Decending/E7020E_lab2/Lab1.kicad_pcb

## KiCad design Lab1.kicad_pcb (2021-02-03)

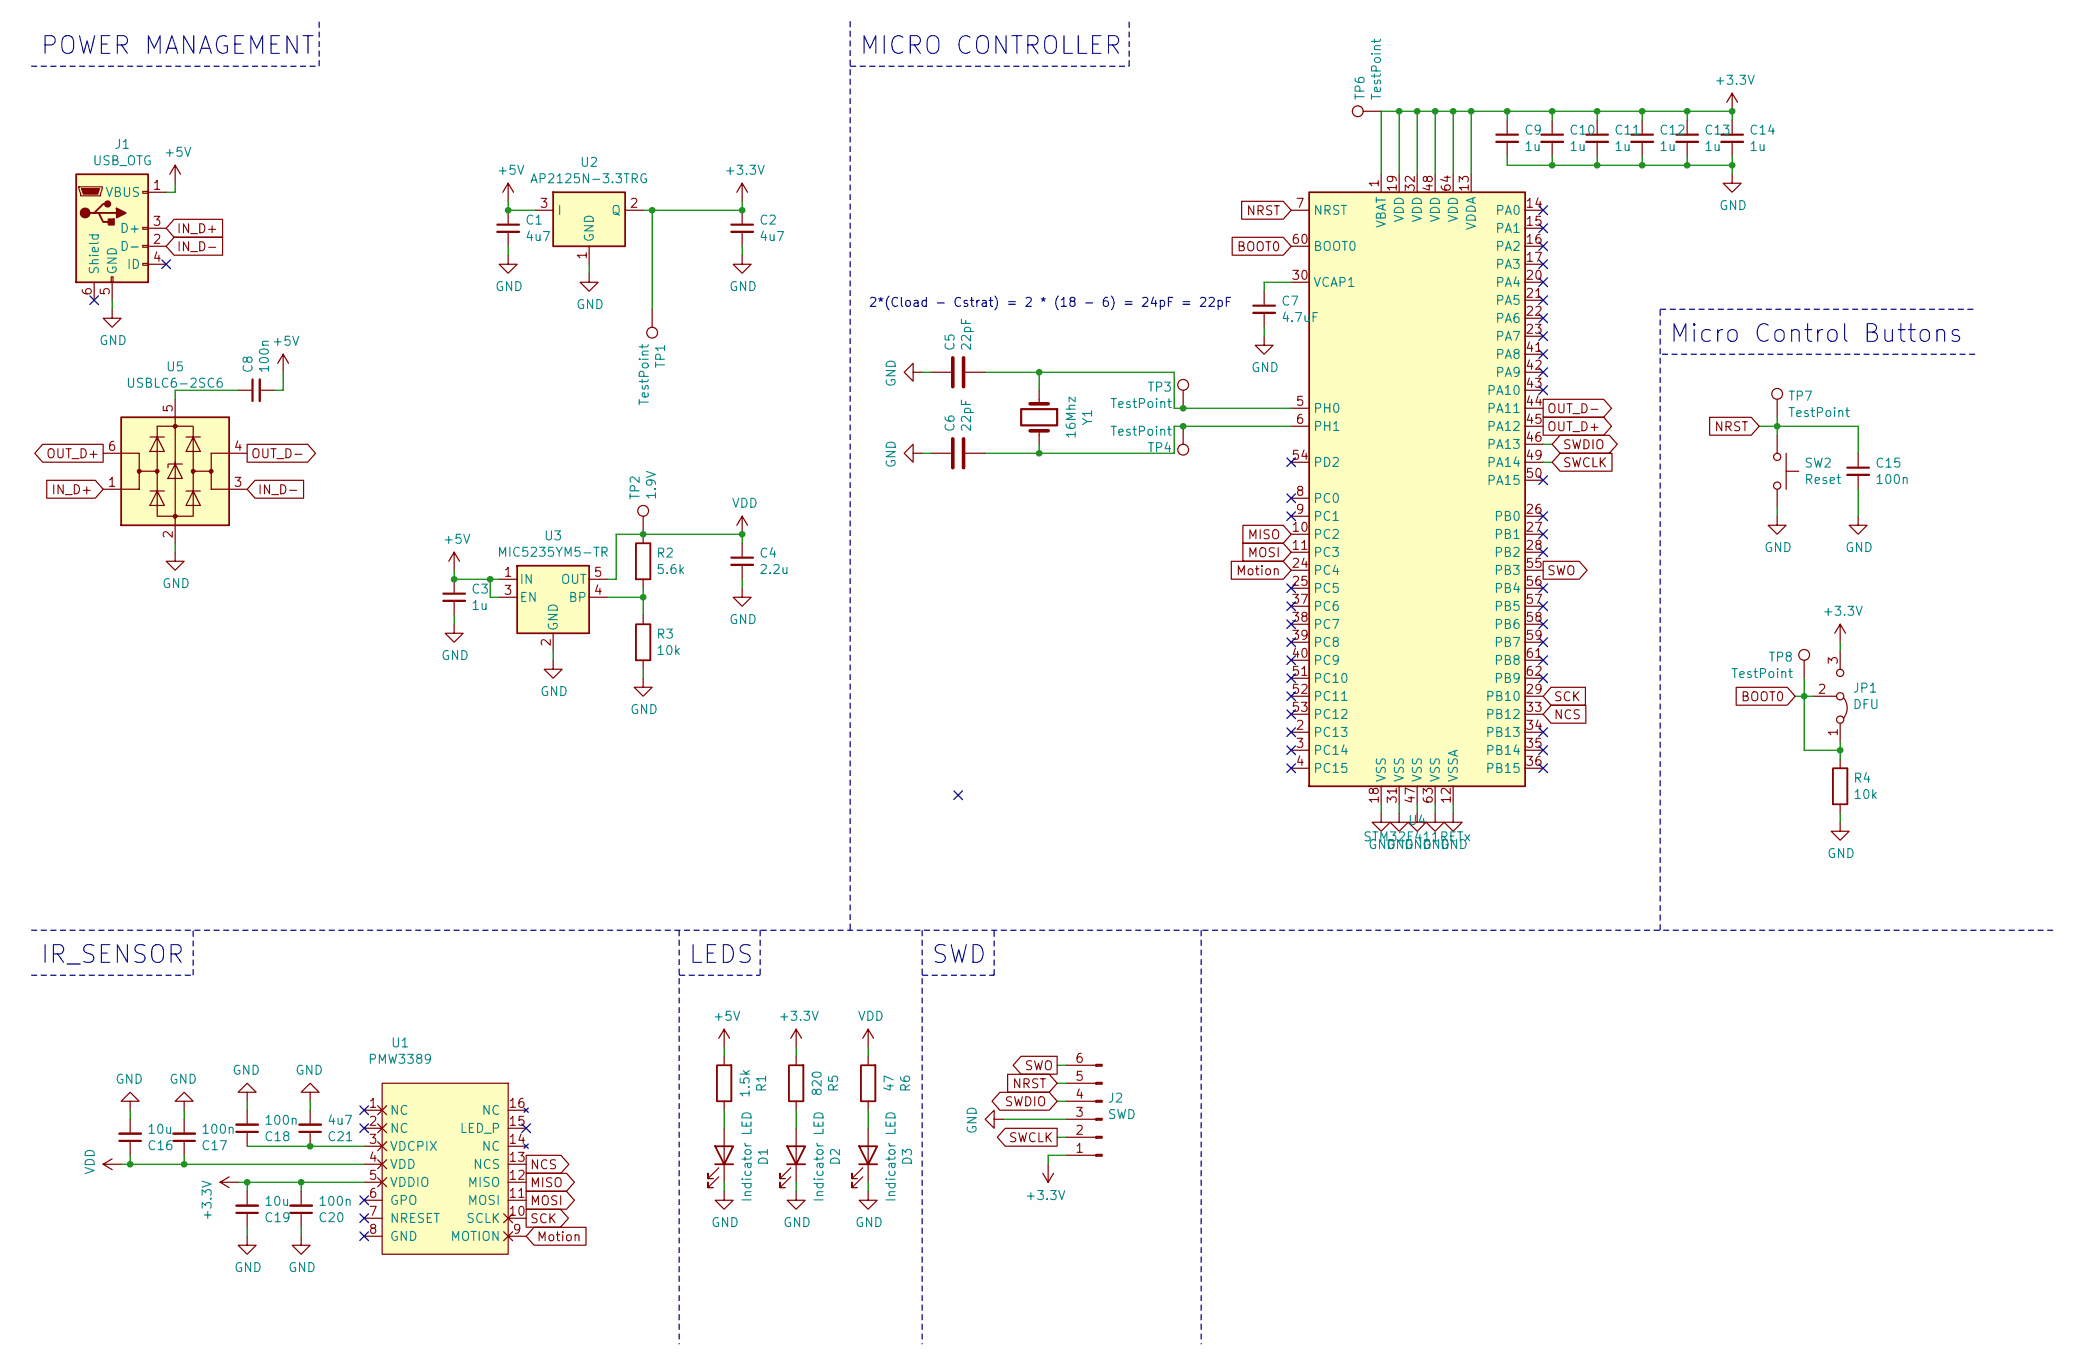
[picture p1: schematic Lab1.sch]

Parts:
C1, C2, C21: 4u7; C_0805_2012Metric_Pad1.18x1.45mm_HandSolder
C3, C9, C10, C11, C12, C13, C14: 1u; C_0805_2012Metric_Pad1.18x1.45mm_HandSolder
C4: 2.2u; C_0805_2012Metric_Pad1.18x1.45mm_HandSolder
C5, C6: 22pF; C_0805_2012Metric_Pad1.18x1.45mm_HandSolder
C7: 4.7uF; C_0805_2012Metric_Pad1.18x1.45mm_HandSolder
C8, C15, C17, C18, C20: 100n; C_0805_2012Metric_Pad1.18x1.45mm_HandSolder
C16, C19: 10u; C_0805_2012Metric_Pad1.18x1.45mm_HandSolder
D1, D2, D3: Indicator LED; LED_1206_3216Metric
J1: USB_OTG; USB_Mini-B_Tensility_54-00023_Vertical
J2: SWD; PinHeader_1x06_P2.00mm_Vertical
JP1: DFU; FanPinHeader_1x03_P2.54mm_Vertical
R1: 1.5k; R_0815_2038Metric_Pad1.20x4.05mm_HandSolder
R2: 5.6k; R_0815_2038Metric_Pad1.20x4.05mm_HandSolder
R3, R4: 10k; R_0815_2038Metric_Pad1.20x4.05mm_HandSolder
R5: 820; R_0815_2038Metric_Pad1.20x4.05mm_HandSolder
R6: 47; R_0815_2038Metric_Pad1.20x4.05mm_HandSolder
SW2: Reset; SW_SPST_B3U-1000P
TP1, TP3, TP4, TP6, TP7, TP8: TestPoint; TestPoint_Pad_1.5x1.5mm
TP2: 1.9V; TestPoint_Pad_1.5x1.5mm
U1: PMW3389
U2: AP2125N-3.3TRG; TO-252-3_TabPin2
U3: MIC5235YM5-TR; SOT-23-5
U4: STM32F411RETx; LQFP-64_10x10mm_P0.5mm
U5: USBLC6-2SC6; SOT-23-6
Y1: 16Mhz; Crystal_SMD_0603-2Pin_6.0x3.5mm_HandSoldering

Connections:
+3V3: C2.1, C9.1, C10.1, C11.1, C12.1, C13.1, C14.1, C19.2, C20.2, J2.1, JP1.3 (B), R5.2, TP1.1, TP6.1, U1.5 (VDDIO), U2.2 (Q), U4.1 (VBAT), U4.13 (VDDA), U4.19 (VDD), U4.32 (VDD), U4.48 (VDD), U4.64 (VDD)
+5V: C1.1, C3.1, C8.2, J1.1 (VBUS), R1.2, U2.3 (I), U3.1 (IN), U3.3 (EN)
BOOT0: JP1.1 (A), JP1.2 (C), R4.1, TP8.1, U4.60 (BOOT0)
GND: C1.2, C2.2, C3.2, C4.2, C5.1, C6.1, C7.2, C9.2, C10.2, C11.2, C12.2, C13.2, C14.2, C15.2, C16.2, C17.2, C18.2, C19.1, C20.1, C21.2, D1.1 (K), D2.1 (K), D3.1 (K), J1.5 (GND), J2.3, R3.2, R4.2, SW2.2, U2.1 (GND), U3.2 (GND), U4.12 (VSSA), U4.18 (VSS), U4.31 (VSS), U4.47 (VSS), U4.63 (VSS), U5.2 (GND)
IN_D+: J1.3 (D+), U5.1 (I/O1)
IN_D-: J1.2 (D-), U5.3 (I/O2)
MISO: U1.12 (MISO), U4.10 (PC2)
MOSI: U1.11 (MOSI), U4.11 (PC3)
Motion: U1.9 (MOTION), U4.24 (PC4)
NCS: U1.13 (NCS), U4.33 (PB12)
NRST: C15.1, J2.5, SW2.1, TP7.1, U4.7 (NRST)
unnamed: C5.2, TP3.1, U4.5 (PH0), Y1.1
unnamed: C6.2, TP4.1, U4.6 (PH1), Y1.2
unnamed: C7.1, U4.30 (VCAP1)
unnamed: C8.1, U5.5 (VBUS)
unnamed: C18.1, C21.1, U1.3 (VDCPIX)
unnamed: D1.2 (A), R1.1
unnamed: D2.2 (A), R5.1
unnamed: D3.2 (A), R6.1
unnamed: R2.2, R3.1, U3.4 (BP)
OUT_D+: U4.45 (PA12), U5.6 (I/O1)
OUT_D-: U4.44 (PA11), U5.4 (I/O2)
SCK: U1.10 (SCLK), U4.29 (PB10)
SWCLK: J2.2, U4.49 (PA14)
SWDIO: J2.4, U4.46 (PA13)
SWO: J2.6, U4.55 (PB3)
VDD: C4.1, C16.1, C17.1, R2.1, R6.2, TP2.1, U1.4 (VDD), U3.5 (OUT)

Notes on the sheet:
2*(Cload - Cstrat) = 2 * (18 - 6) = 24pF = 22pF
POWER MANAGEMENT
MICRO CONTROLLER
IR_SENSOR
LEDS
SWD
Micro Control Buttons

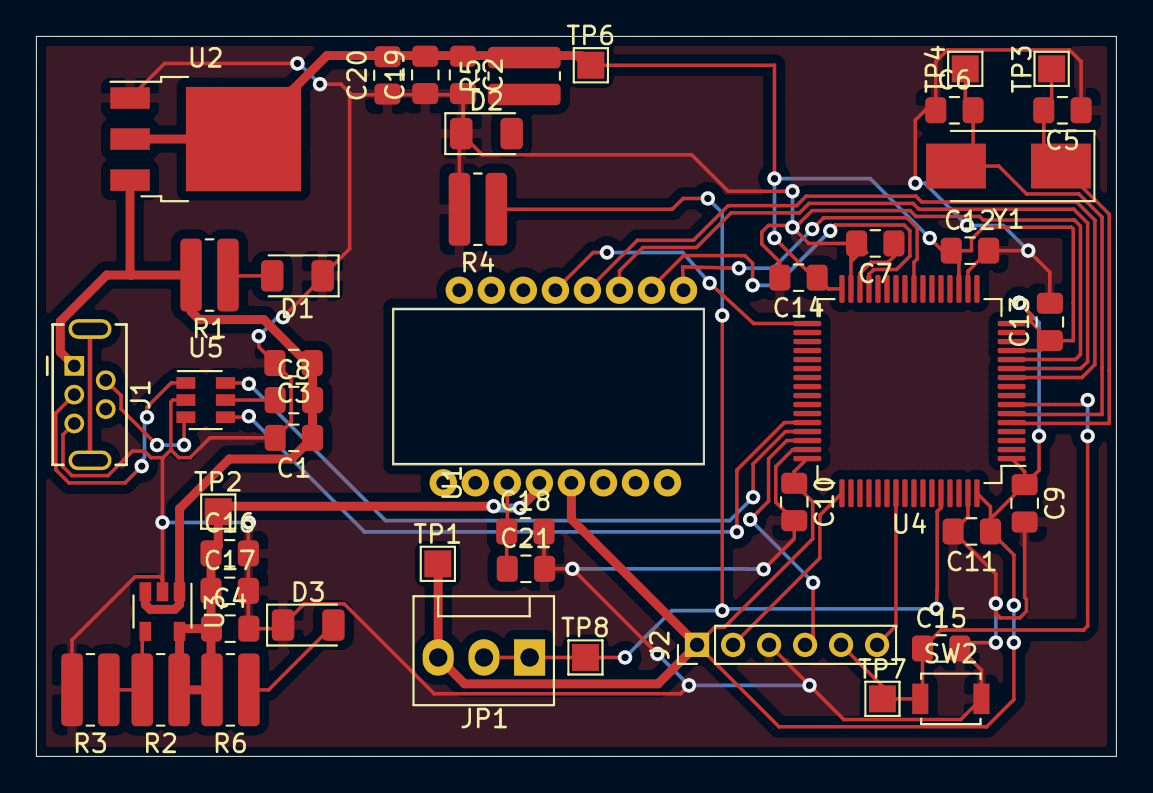
[picture p2: board Lab1.kicad_pcb from above]

Board: 2 copper layers, 60.0 x 40.0 mm, 47 parts (0 on the bottom side), 27 nets.
