Decending/E7020E_lab2/(threads)

Thread 1 (2021-01-31):

Review

ka11i0, 2021-01-31:
1) Bra.
2) Bra.
3) Det ser bra ut, gillar din layout, tänk bara på att decoupling capacitors ska sitta så nära MCUn som möjligt. Du kan också ändra footprinten för restistorerna till 0805, så får du lite mer plats.
4) De spåren du har dragit över sensorytan kommer inte funka då det ska va en cutout där. Sen vet jag inte om man kan ha vias direkt på en komponent, alltså rakt genom resistor kontakten, men funkar mitt på chippet (enligt "experten" jag konsulterat med). Saknas två kontakter, lättfixade dock. Nu när jag ser hur du har gjort fattar jag äntligen hur man använder "filled zones". :)
5) Som tidigare nämnt har du ingen cutout för PMWn.
6) 2 Errors.

Decending, 2021-02-02:
Jag har gjort en ny design nu, kolla gärna över att jag har fixat alla problem du har pekat ut!

ka11i0, 2021-02-02:
Det ser bra ut!

Closed 2021-02-02.

Thread 2 (2021-02-01):

Review lab 2

kottz, 2021-02-01:
Nice job overall! I thought about a few things:

- The orientation and placement of the sensor do not match the recommended orientation given in the datasheet (page 7).
- There is no cutout under the sensor so there is no way to mount the lens. See page 9 in the datasheet.
- The placement of the USB connector could probably be changed. It should probably be placed in the front of the mouse at the edge of the PCB. Could probably be a bit awkward having the USB cable sticking out the side of the mouse.
- The decoupling capacitors could probably be placed even closer to their respective pins on the MCU. I don't know if you remember Henrik's lecture about lab 2 but he started with the decoupling capacitors and placed them as close as physically possible to each pin.
- When I run the DRC I get a couple of "Track too close to pad". The Motion and SCK vias are touching the C7 capacitor.

Other than that I think it looks pretty good!

Decending, 2021-02-02:
I've made a new design now, please make sure I've addressed your points!
