Decending/E7020E_lab2/(commit log)

2021-01-29 Initial upload - part 4 recently completed
    Might want to redo part 4, as the spaghetti might be a bit too much...
    [Lab1.kicad_pcb, Lab1.sch]
2021-02-02 Backup of working 1st prototype
    [Lab1.kicad_pcb]
2021-02-02 2nd design, quite happy with this one!
    [Lab1.kicad_pcb]
2021-02-03 Fixed decoupling capacitors
    [Lab1.kicad_pcb]
